tronfu/Voron-Mods/README.md

# Voron-Mods

A collection of my mods for Voron 2.4 and Trident
