tronfu/Voron-Mods/Retractable_Probe_Dock/README.md

# A Servo-powered Retractable Dock for Klicky Probe and Nozzle Brush
## for Voron 2.4 and Trident

<table>
  <tr>
    <td>
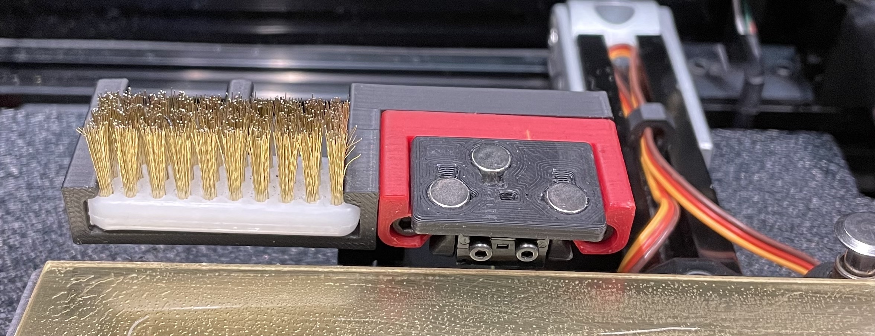
[picture p12: Retractable_Probe_Dock/Images/servo_dock_and_brush.jpg]
       
    </td>
    <td>
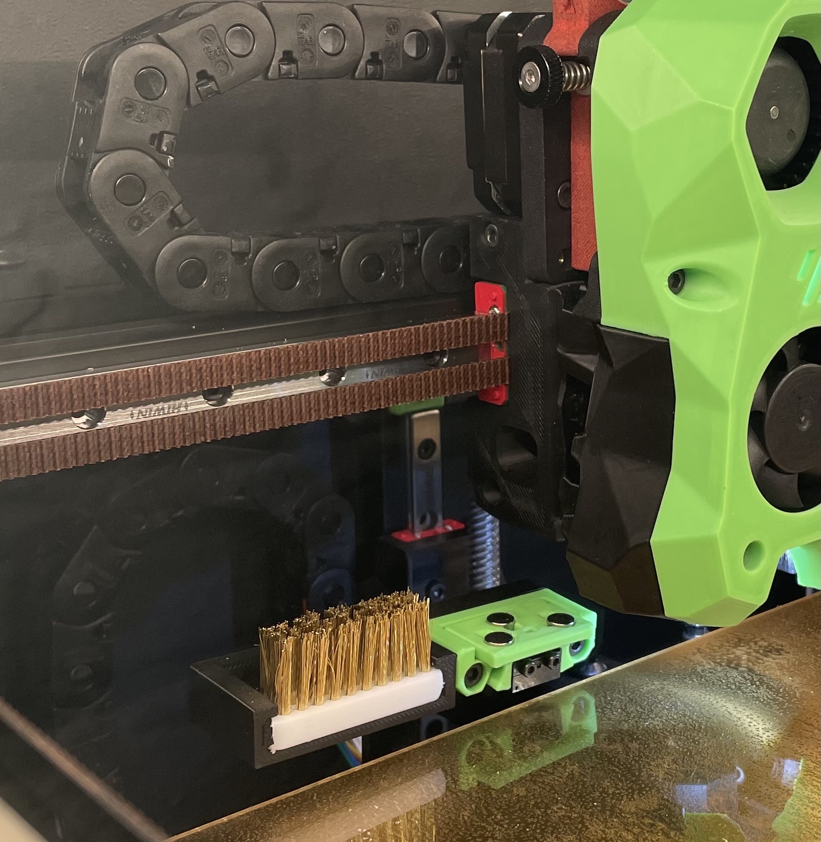
[picture p13: Retractable_Probe_Dock/Images/trident_extended_dock_front_view.jpg]
      
    </td>
  </tr>
</table>

## Background

I was not quite content with how the fixed nozzle worked. The back and forth motion of the nozzle either did not get the plastic bits off or got them off in one direction but picked them back up on the way back. Also, while I really like the Klicky probe, I had trouble consistently docking and undocking with the fixed Klicky probe dock on my Voron 2.4 350. Docking and undocking would work for a few print cycles then dock became slightly too far back for the toolhead to reach. So I created this servo-powered retractable dock and nozzle brush combo.

<table>
  <tr>
    <td>
       
    </td>
    <td>
      
    </td>
  </tr>
</table>

Below is a comparison of the servo brush vs. the stock fix brush.
<table>
  <tr>
    <td>
  <figure>
  
  &nbsp;<br/>
  <figcaption align="center">Nozzle after cleaning with fixed brush</figcaption>
  </figure>
  </td>
  <td>
  <figure>
  
  &nbsp;<br/>
  <figcaption align="center">Nozzle after cleaning with the servo brush</figcaption>
  </figure>
  </td>
  </tr>
</table>
&nbsp;<br/>
&nbsp;<br/>
You can certainly choose to use this design for only the Klick probe dock or only the nozzle brush by skipping the parts and assembly for the respective functionality. 

## BOM

Common:
* 1 x SG90 12g analog servo with metal gears, such as this one https://www.amazon.com/gp/product/B07KYK9N1G/
* 3 x 22-26 AWG wires at a length that can reach from the servo mounted by the print bed to your MCU
* 1 x JST XH Connector Plug 3 Position (for connecting to MCU)
* 1 x MicroFit3 Connector Receptacle 3 Position (for the other end of cable from MCU)
* 1 x MicroFit3 Connector Plug 3 Position (replace existing connector on the servo)
* 2 x M5x10mm BHCS screws  (for mounting the housing to the extrusion)
* 2 x M5 Spring T-nuts (for mounting the housing to the extrusion)
* 1 x M2x6mm screw (for securing the dock adaptor arm to the servo)

---
**NOTE**

A digital servo would work also. But some digital servos may flutter during extension (i.e., rapid vibrating as it tries to find the precise angle). An analog servo does not have this problem.

---
Klicky probe dock:
* 2 x M3x5mmx4mm heat inserts (for the dock adaptor arm)
* 2 x M3x20mm screws (for securing the dock to the dock adaptor arm, the same two screws used in the stock fixed dock setup)

Nozzle brush:
* 1 x Brass nozzle brush, such as this one https://www.amazon.com/gp/product/B092HWQG69. Of course, you can use a nozzle brush made of other materials, such as a silicone brush. But the current  brush holder has been tested for fit with brass nozzle from Amazon listed above.

## Assembly

### Setup the servo config
* Copy the retractable_probe_dock.cfg  to the directory where your printer.cfg file is (e.g., /home/pi/).

* In your printer.cfg file, also add the following [include retractable_probe_dock.cfg]. You can add it right after [include klicky-probe.cfg]. For example, this is what it looks like in my printer.cfg.
```
#####################################################################
# 	Macros
#####################################################################
[include klicky-probe.cfg]
[include retractable_probe_dock.cfg]
[include z_calibration.cfg]
```

* Add the following servo section to your printer.cfg.

```
[servo probe_dock_servo]
pin: P2.0            # P2.0 is for Skr 1.4, use the appropriate pin for your MCU
#   PWM output pin controlling the servo. This parameter must be
#   provided.
maximum_servo_angle: 180
#   The maximum angle (in degrees) that this servo can be set to. The
#   default is 180 degrees.
minimum_pulse_width: 0.0005
#   The minimum pulse width time (in seconds). This should correspond
#   with an angle of 0 degrees. The default is 0.001 seconds.
maximum_pulse_width: 0.0025
#   The maximum pulse width time (in seconds). This should correspond
#   with an angle of maximum_servo_angle. The default is 0.002
#   seconds.
initial_angle: 175
#   Initial angle (in degrees) to set the servo to. The default is to
#   not send any signal at startup.
#initial_pulse_width:
#   Initial pulse width time (in seconds) to set the servo to. (This
#   is only valid if initial_angle is not set.) The default is to not
#   send any signal at startup.
```
* Add extend_probe_dock and retract_probe_dock commands to attach_probe and dock_probe macros in your klicky-probe.cfg. See example below for where to insert. You can find a copy of my klicky-probe.cfg in the Macros folder for additional reference.

```
[gcode_macro Attach_Probe]

        ...

        _entry_point function=Attach_Probe_intern

        # RETRACTABLE BEGIN
        extend_probe_dock
        # RETRACTABLE END
        
        # Probe entry location
        G0 X{docklocation_x|int - attachmove_x|int} Y{docklocation_y|int - attachmove_y|int} F{travel_feedrate}
        {% if docklocation_z != -128 %}
            G0 Z{docklocation_z|int - attachmove_z|int} F{dock_feedrate}
        {% endif %}

        # Drop Probe to Probe location
        {% if docklocation_z != -128 %}
            G0 Z{docklocation_z} F{dock_feedrate}
        {% endif %}
        G0 X{docklocation_x} Y{docklocation_y} F{dock_feedrate}

        # Probe Attach
        {% if docklocation_z != -128 %}
        G0 Z{docklocation_z|int - attachmove_z|int} F{z_drop_feedrate}
        {% endif %}
        G0 X{docklocation_x|int - attachmove_x|int} Y{docklocation_y|int - attachmove_y|int} F{release_feedrate}

        # RETRACTABLE BEGIN
        retract_probe_dock
        # RETRACTABLE END
        
        # Go to Z safe distance
        {% if printer.toolhead.position.z < safe_z %}

        ...
        
[gcode_macro Dock_Probe]
    ...

        _Umbilical_Path

        # RETRACTABLE BEGIN
        extend_probe_dock
        # RETRACTABLE END
        
        # Probe entry location
        G0 X{docklocation_x|int - attachmove_x|int} Y{docklocation_y|int - attachmove_y|int} F{travel_feedrate}
        {% if docklocation_z != -128 %}
            G0 Z{docklocation_z|int - attachmove_z|int} F{dock_feedrate}
        {% endif %}

        # Drop Probe to Probe location
        G0 X{docklocation_x} Y{docklocation_y} F{dock_feedrate}
        {% if docklocation_z != -128 %}
            G0 Z{docklocation_z} F{dock_feedrate}
        {% endif %}

        # Probe decoupling
        {% if docklocation_z != -128 %}
            G0 Z{docklocation_z|int + dockmove_z|int} F{release_feedrate}
        {% endif %}
        G0 X{docklocation_x|int + dockmove_x|int} Y{docklocation_y|int + dockmove_y|int} F{release_feedrate}
        
        # RETRACTABLE BEGIN
        # RETRACTABLE adds the move below to move it back within max_bed_y
        G0 Y{docklocation_y|int - attachmove_y|int} F{release_feedrate}
        retract_probe_dock
        # RETRACTABLE END
        
        # Go to Z safe distance
        {% if printer.toolhead.position.z < safe_z %}
        
        ...        
```
### Wiring the servo to the MCU
* Power off the printer.
* Attach the servo to the servo port on your MCU. For example, on a SKR 1.4 Turbo, the servo port is the one inside the orange box shown in the picture below. 
<table>
  <tr>
    <td width="50%">

  </td>
  <td>
The three pins from the servo port labeled GND, NPWR, and 2.0 should be connected to the Negative Pole (Brown), Positive Pole (Red), and Signal (Yellow) pins of the Micro Servo as shown in the picture below.

  </td>
  </tr>
</table>

* Crimp the MicroFit3 Connector Receptacle onto the wires from mcu.
* Cut off the existing connector on the servo.
* Crimp the MicroFit3 Connector Plug onto the servo wires.

### Install the nozzle brush (skip if you are not using the Klicky probe dock feature)
* Heat set the two heat inserts.
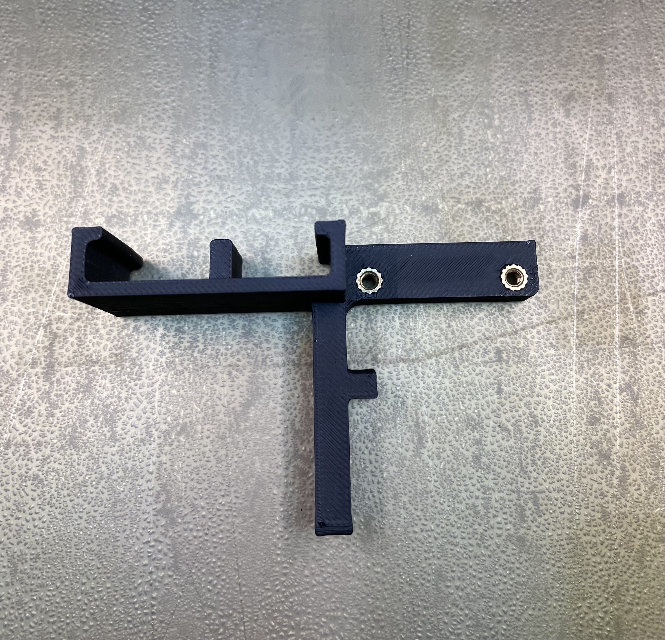
[picture p14: Retractable_Probe_Dock/Images/install_heat_inserts.jpg]


* Install the probe dock using the two M3 screws (the same ones for the stock dock mount).

### Install the nozzle brush (skip if you are not using the nozzle brush feature)
* Trim the nozzle brush so that it fits in the holder.


* Insert the trimmed brush into the holder.
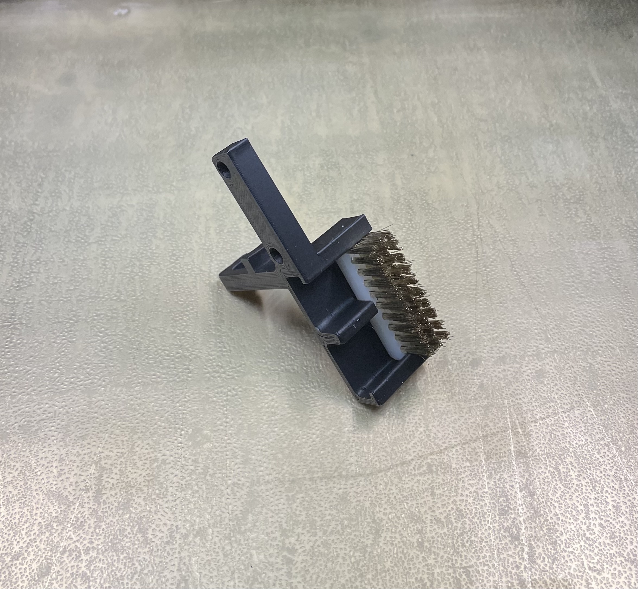
[picture p15: Retractable_Probe_Dock/Images/install_brush.jpg]

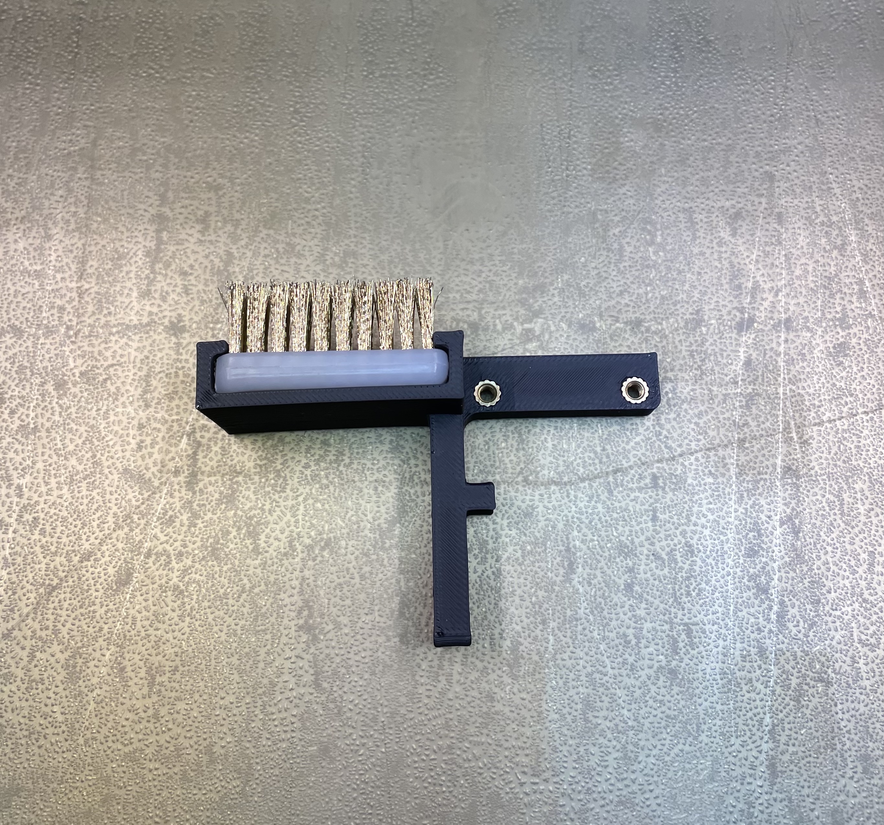
[picture p16: Retractable_Probe_Dock/Images/servo_arm_with_brush.jpg]


### Final assembly
* Install the servo into the housing using the two self-threading screws that come with the servo.



* Install the impact shield by pushing it all the way into the housing.
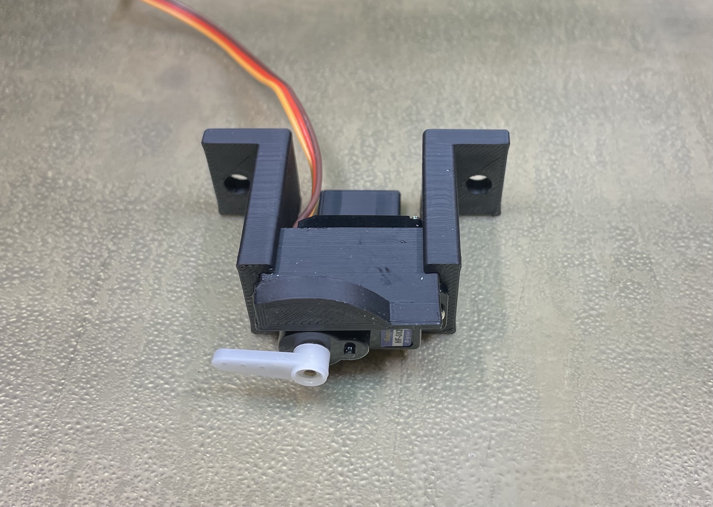
[picture p17: Retractable_Probe_Dock/Images/install_impact_shield.jpg]


* Put the two spring T-nuts in the extrusion and mount the housing to the extrusion (about 40 mm from the print bed on a V2.4 350). Don't tighten them too much. We will want to adjust the distance from the housing to the edge of the print bed.
* Connect the servo to the wires from the MCU.
* Power on the printer. If you have correctly inserted [servo probe_dock_servo] section into your printer.cfg, you should see the servo moving to the initial angle (e.g., 175 deg. in the sample setup) position up on boot up.
* Type the following command in a terminal to Klipper (e.g., under Octoprint's terminal tab): retractable_probe_dock.
(You should hear some clicking sound but the servo gear may not spin because it is at its initial angle position.)
* Attach the white plastic wing that came with the servo to the top of the servo. You can just press it down but don't need to screw it in yet.


* Put the dock adaptor arm over the white plastic wing, and secure the arm using a M2x6mm machine screw.
---
**NOTE**

You should use a small dab of Loctite (I used the red variety) on the the M2 screw to avoid having to re-tighten it periodically.

---
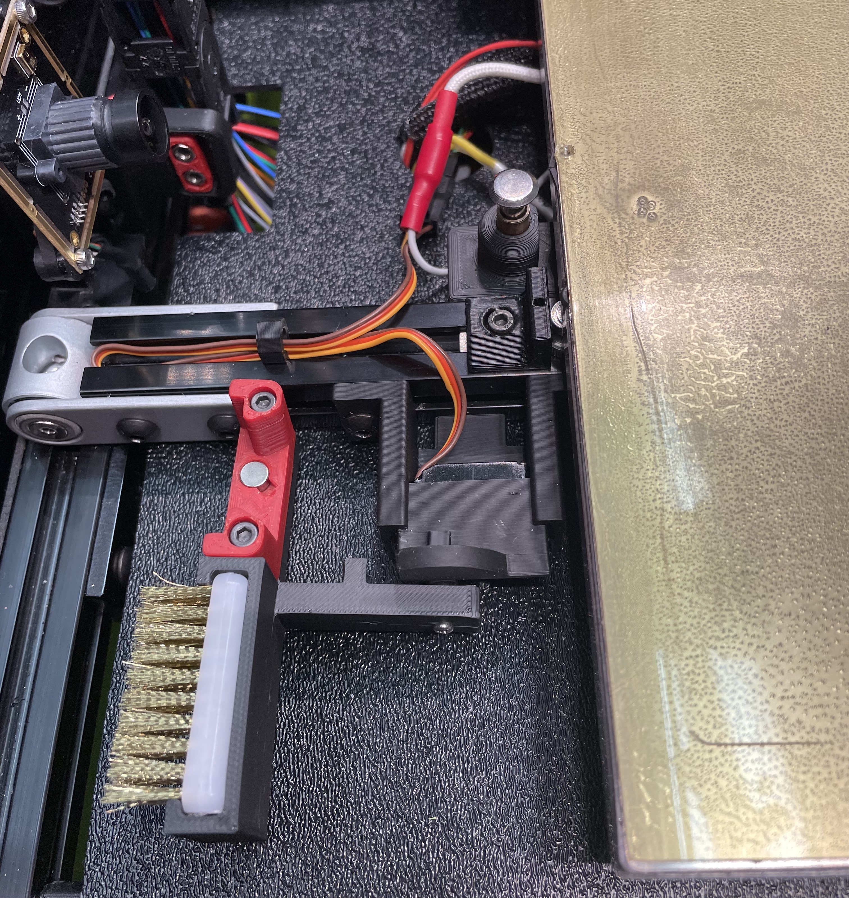
[picture p18: Retractable_Probe_Dock/Images/fully_installed.jpg]



### Initial configuration
* First, do a G28 to home everything.
* Do a few extend_probe_dock and retract_probe_dock to make sure the servo is working correctly.
### Skip the following steps if you are not using the Klicky probe dock feature
* Do a extend_probe_dock, then g0 z40.
* Then move your toolhead to be right above the extended dock using the G0 X__ Y__. 
* Slowly lower the z until the probe holder in the toolhead makes contact with the probe
* Do a GET_POSITION to get the X Y Z positions.
* Update klicky-probe.cfg with the positions (see example setup below)
```
variable_docklocation_x:        63    # X Dock position
variable_docklocation_y:        325   # Y Dock position
variable_docklocation_z:        9     # Z dock position (-128 for a gantry mount)

```
* Save the updated klicky-probe.cfg and do a FIRMWARE_RESTART
* Do a G28 to home XYZ
* Do an attach_probe and a dock_probe to see the retractable dock working as intended.

#### Skip the following steps if you are not using the nozzle brush feature
* Do an extend_probe_dock
* Move the nozzle until the x is at the brush start and y is at brush_front
```
                  ←   brush_width   →                            
                   _________________                                                          ↑                 |                 |  ↑                     
  brush_start (x) |                 | brush_depth            
                  |_________________|  ↓                                      
                          (y)                                                                
↓                      brush_front
 __________________________________________________________
                     PRINTER FRONT
```

* Do a GET_POSITION and update retractable_probe_dock.cfg (see example setup below)
```
variable_brush_front:       340          
variable_brush_depth:       10       
``` 
* Do a FIRMWARE_RESTART followed by a G28 to home everything
* Do a cleaning_nozzle to see the brushing in action

### Auto docklocation_z configuration
* Copy the calibrate_docklocation_z.py script into the klipper/klippy/extras directory (e.g., on my set up the full path is /home/pi/klipper/klippy/extras).
* Make sure you have the latest retractable_probe_dock.cfg that has the following configuration:
```
[calibrate_docklocation_z]
#speed:                       50     # default 50
##  the toolhead will start at docklocation_z_max and move down to
##  docklocation_z_min to find the correct docklocation_z
docklocation_z_max:          30
docklocation_z_min:          8       
##  The magnet will pull the dock up when doing a CALIBRATE_DOCKLOCATION_Z. 
##  The docklocation_z_offset will compensate for that by setting the docklocation_z 
##  slightly lower
docklocation_z_offset:       -2 

[gcode_macro find_docklocation_z]
gcode:
    {% set docklocation_x = printer["gcode_macro _User_Variables"].docklocation_x %}
    {% set docklocation_y = printer["gcode_macro _User_Variables"].docklocation_y %}
    {% set dockmove_x = printer["gcode_macro _User_Variables"].dockmove_x|default(0) %}
    {% set dockmove_y = printer["gcode_macro _User_Variables"].dockmove_y|default(0) %}
    {% set release_feedrate = printer["gcode_macro _User_Variables"].release_feedrate|default(1000) %}
    extend_probe_dock
    CALIBRATE_DOCKLOCATION_Z X={docklocation_x} Y={docklocation_y}
    G0 X{docklocation_x|int + dockmove_x|int} Y{docklocation_y|int + dockmove_y|int} F{release_feedrate}
    { action_respond_info("find_sdocklocation_z: " + printer.calibrate_docklocation_z.docklocation_z|string) }
    
[gcode_macro set_docklocation_z]
gcode:
    SET_GCODE_VARIABLE MACRO=_User_Variables VARIABLE=docklocation_z VALUE={printer.calibrate_docklocation_z.docklocation_z}
    { action_respond_info("set_docklocation_z: " + printer.calibrate_docklocation_z.docklocation_z|string) }
    
## Wrapper macro to get around Jinja expansion order issue
[gcode_macro auto_set_docklocation_z]
gcode:
    find_docklocation_z
    set_docklocation_z
```
* Call the auto_set_docklocation_z macro at least once after you restart your printer (including running RUNNING and FIRMWARE_RESTART commands) before any docking/undocking. For example, you can add auto_set_docklocation_z right after G28 in your G32 definition.
