tronfu/Voron-Mods/Bowden_Tube_Clip/README.md

# Bowden Tube Clip

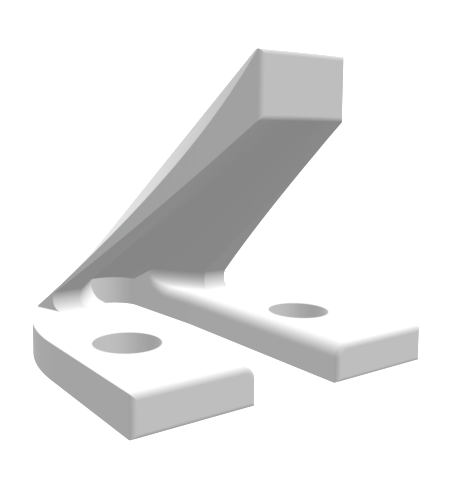
[picture p19: Bowden_Tube_Clip/Images/bowden_tube_clip_3d_render.png]


I created a simple clip to keep the Bowden tube upright and not get caught in the moving chain or the gantry.

## BOM

* 2 x M5x6mm (or M5x8mm) BHCS
* M5 Spring T-nuts

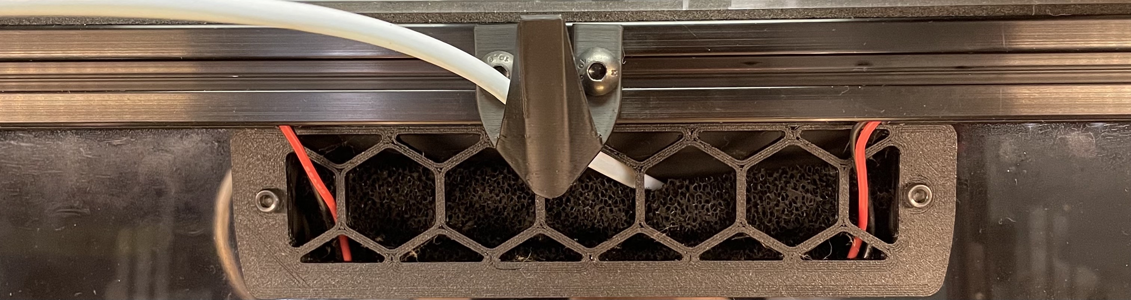
[picture p20: Bowden_Tube_Clip/Images/bowden_tube_clip.jpg]
