tronfu/Voron-Mods/Better_Bed_Hinge/Images/perpendicular_pivot.jpg

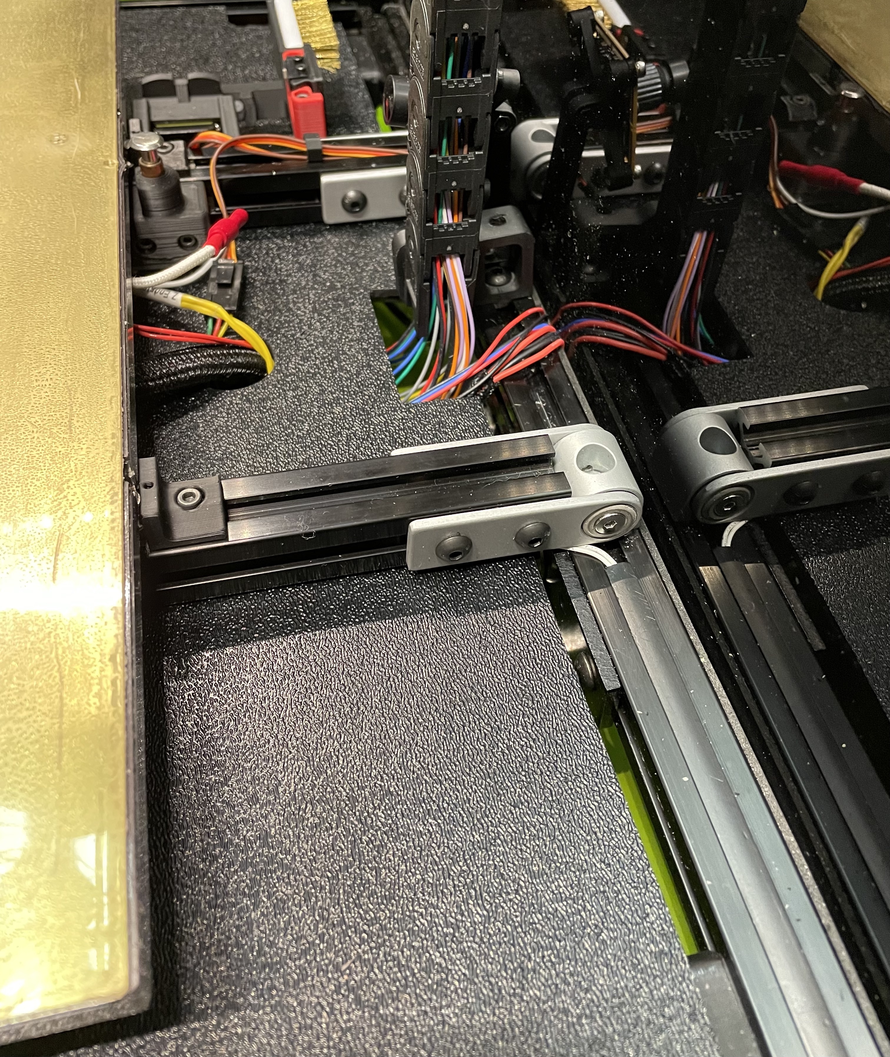
Better_Bed_Hinge/Images/perpendicular_pivot.jpg
