tronfu/Voron-Mods/Retractable_Probe_Dock/Images/12g_EMax_Analog_Servo.jpg

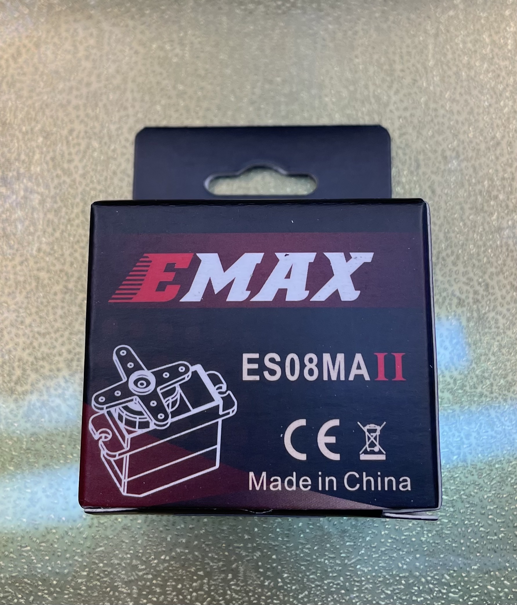
Retractable_Probe_Dock/Images/12g_EMax_Analog_Servo.jpg
