tronfu/Voron-Mods/Retractable_Probe_Dock/Images/completed_servo_arm.jpg

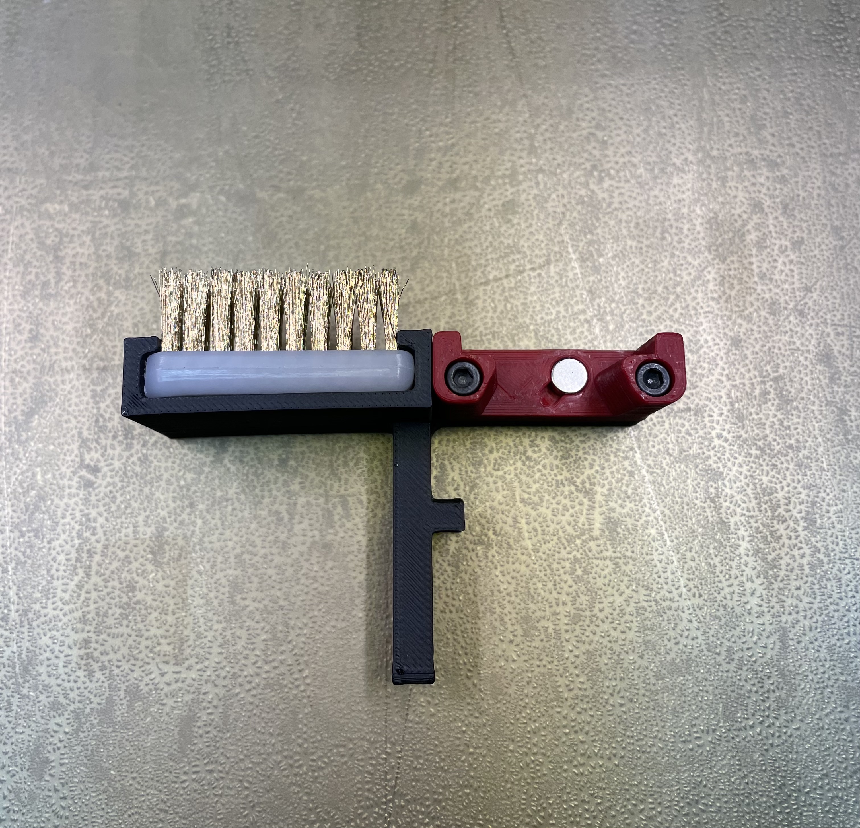
Retractable_Probe_Dock/Images/completed_servo_arm.jpg
