tronfu/Voron-Mods/Retractable_Probe_Dock/Images/trident_retracted_dock.jpg

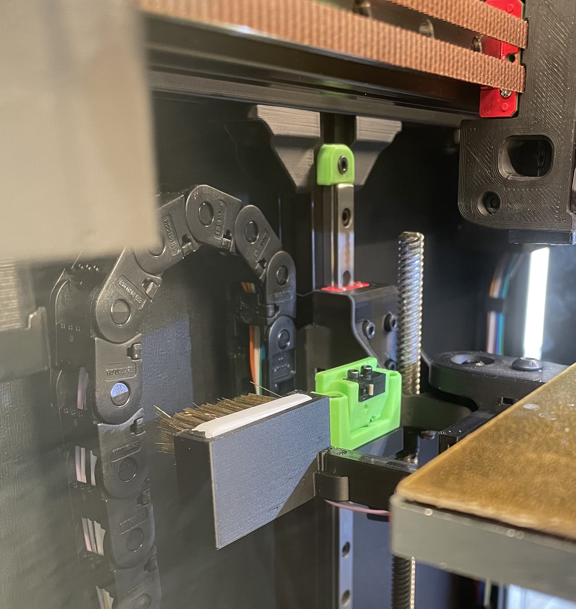
Retractable_Probe_Dock/Images/trident_retracted_dock.jpg
