tronfu/Voron-Mods/Better_Bed_Hinge/DXFs/Deck_Panel_350_Modified.dxf

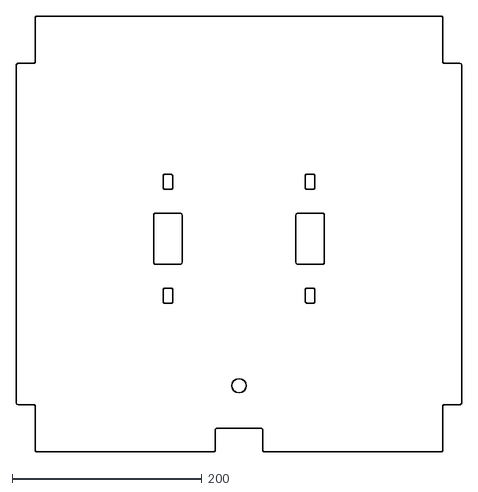
[picture p40: CAD file, 2022-01-28]
Better_Bed_Hinge/DXFs/Deck_Panel_350_Modified.dxf
470.0 x 460.0
