tronfu/Voron-Mods/Better_Bed_Hinge/STLs/DIN_frame_mount_x4.stl

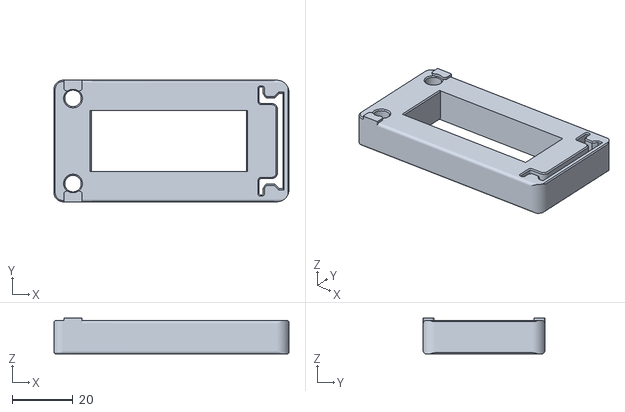
[picture p41: CAD file, 2022-02-01]
Better_Bed_Hinge/STLs/DIN_frame_mount_x4.stl
77.2 x 40.0 x 11.8
