tronfu/Voron-Mods/Bowden_Tube_Clip/STLs/Bowden_tube_clip.stl

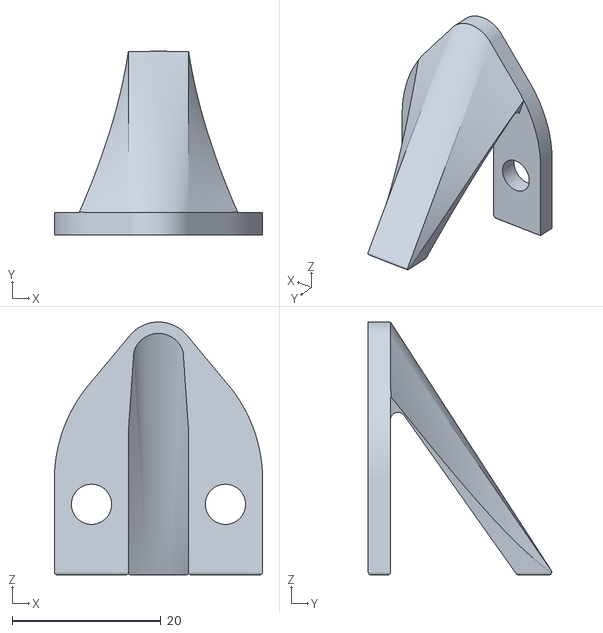
[picture p42: CAD file, 2022-03-06]
Bowden_Tube_Clip/STLs/Bowden_tube_clip.stl
28.0 x 24.7 x 34.0
