tronfu/Voron-Mods/Retractable_Probe_Dock/STLs/Trident_housing.stl

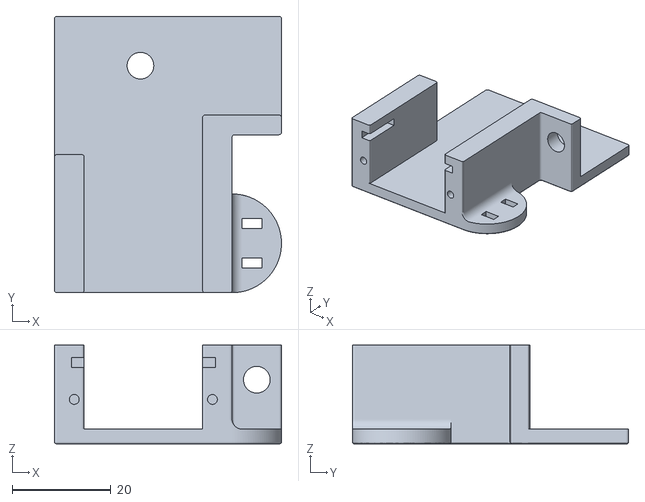
[picture p43: CAD file, 2022-03-03]
Retractable_Probe_Dock/STLs/Trident_housing.stl
46.0 x 56.0 x 20.0
