tronfu/Voron-Mods/Servo_Nozzle_Brush/STLs/Adjustable_brush_holder.stl

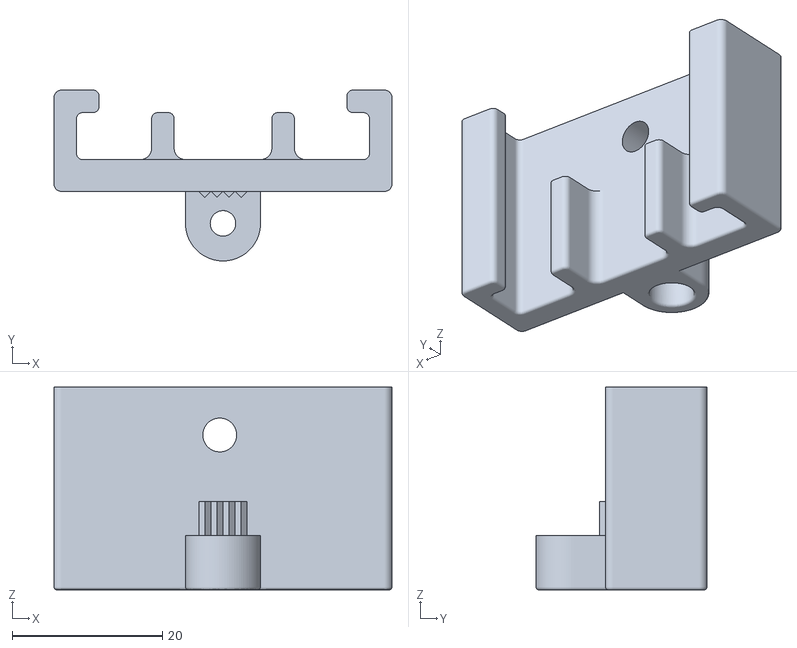
[picture p44: CAD file, 2023-02-01]
Servo_Nozzle_Brush/STLs/Adjustable_brush_holder.stl
45.0 x 22.7 x 27.0
