tronfu/Voron-Mods/Better_Bed_Hinge/STLs/Voron_2.4_Deck_Panel_Hole_Plug_x4.stl

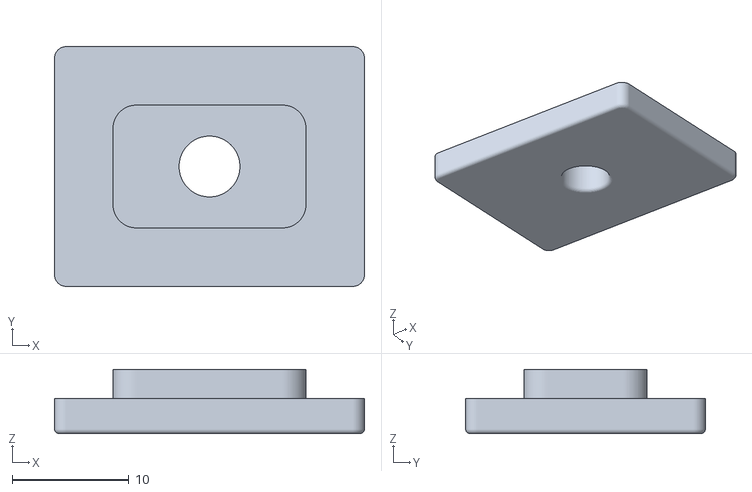
[picture p45: CAD file, 2022-01-28]
Better_Bed_Hinge/STLs/Voron_2.4_Deck_Panel_Hole_Plug_x4.stl
26.5 x 20.5 x 5.50
