tronfu/Voron-Mods/Retractable_Probe_Dock/STLs/Adjustable_arm.stl

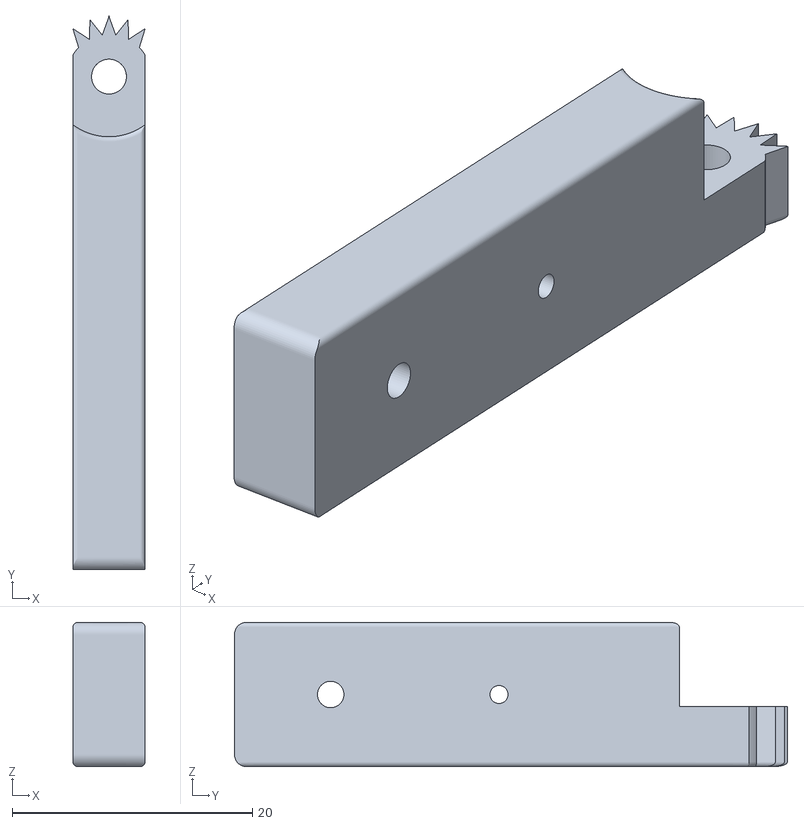
[picture p46: CAD file, 2022-03-03]
Retractable_Probe_Dock/STLs/Adjustable_arm.stl
6.00 x 46.0 x 12.0
