tronfu/Voron-Mods/Better_Bed_Hinge/STLs/Bed_handle.stl

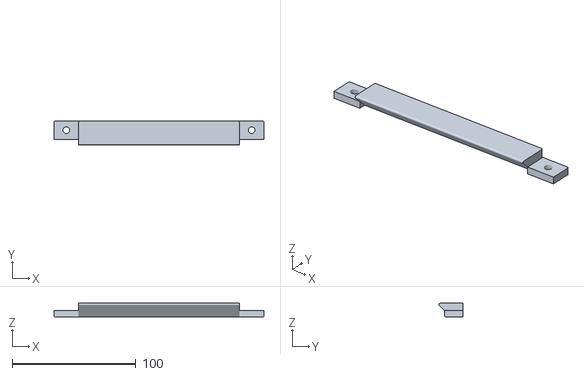
[picture p47: CAD file, 2022-01-28]
Better_Bed_Hinge/STLs/Bed_handle.stl
170.0 x 19.6 x 11.0
