tronfu/Voron-Mods/Retractable_Probe_Dock/STLs/Adjustable_brush_dock_holder.stl

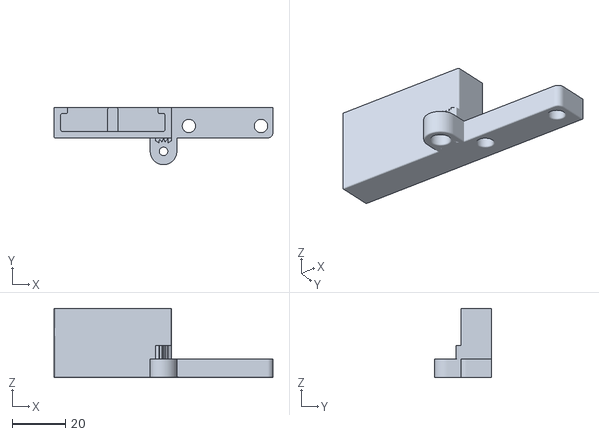
[picture p48: CAD file, 2022-03-03]
Retractable_Probe_Dock/STLs/Adjustable_brush_dock_holder.stl
82.0 x 21.5 x 26.0
