tronfu/Voron-Mods/Retractable_Probe_Dock/STLs/Servo_arm.stl

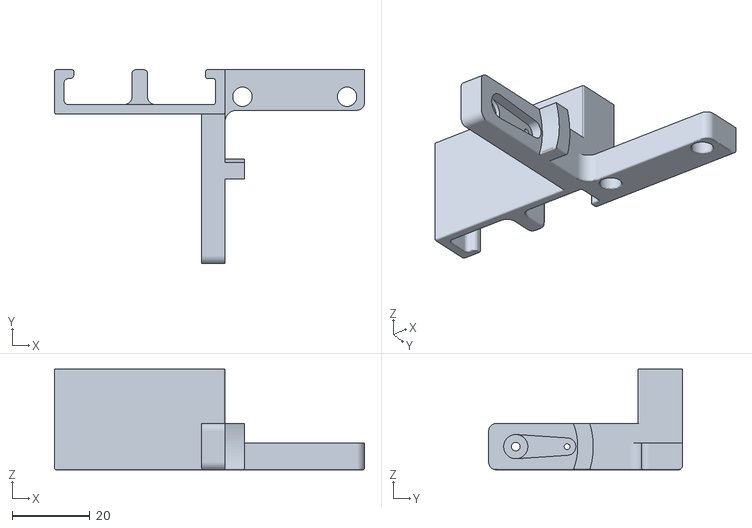
[picture p49: CAD file, 2022-01-23]
Retractable_Probe_Dock/STLs/Servo_arm.stl
80.0 x 50.0 x 26.0
