tronfu/Voron-Mods/Retractable_Probe_Dock/STLs/Impact_relief.stl

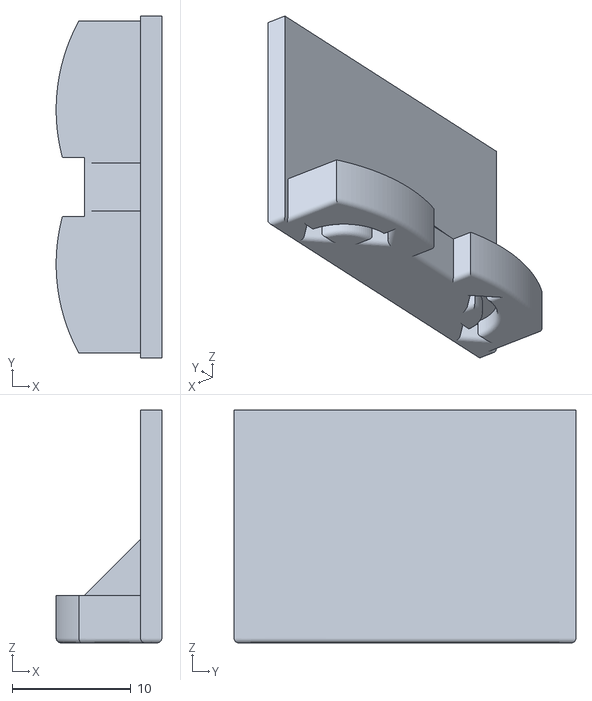
[picture p50: CAD file, 2022-01-23]
Retractable_Probe_Dock/STLs/Impact_relief.stl
8.90 x 28.8 x 19.6
