tronfu/Voron-Mods/Retractable_Probe_Dock/STLs/Housing.stl

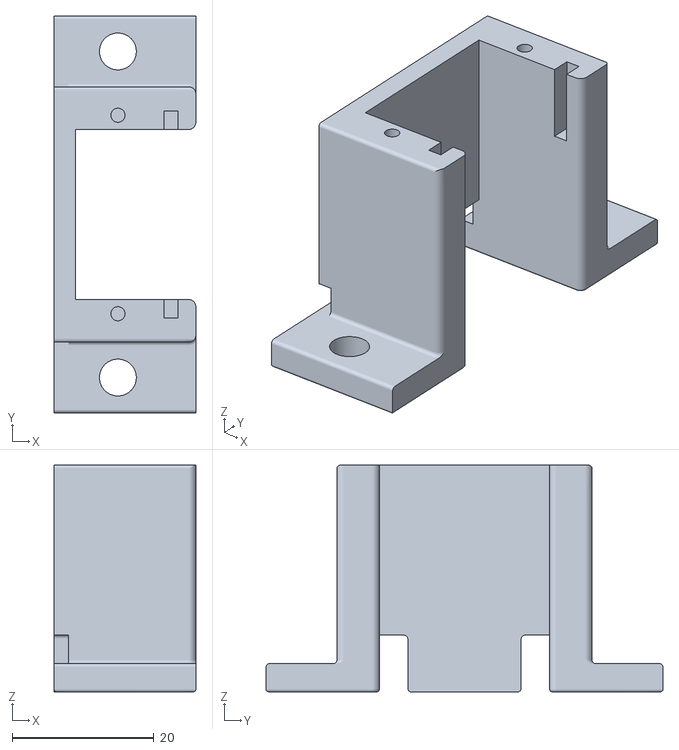
[picture p51: CAD file, 2022-01-23]
Retractable_Probe_Dock/STLs/Housing.stl
20.0 x 56.0 x 32.0
