tronfu/Voron-Mods/Tridex/Auto_3-Axes_Calibration/Images/calibration_tool_side_view.jpg

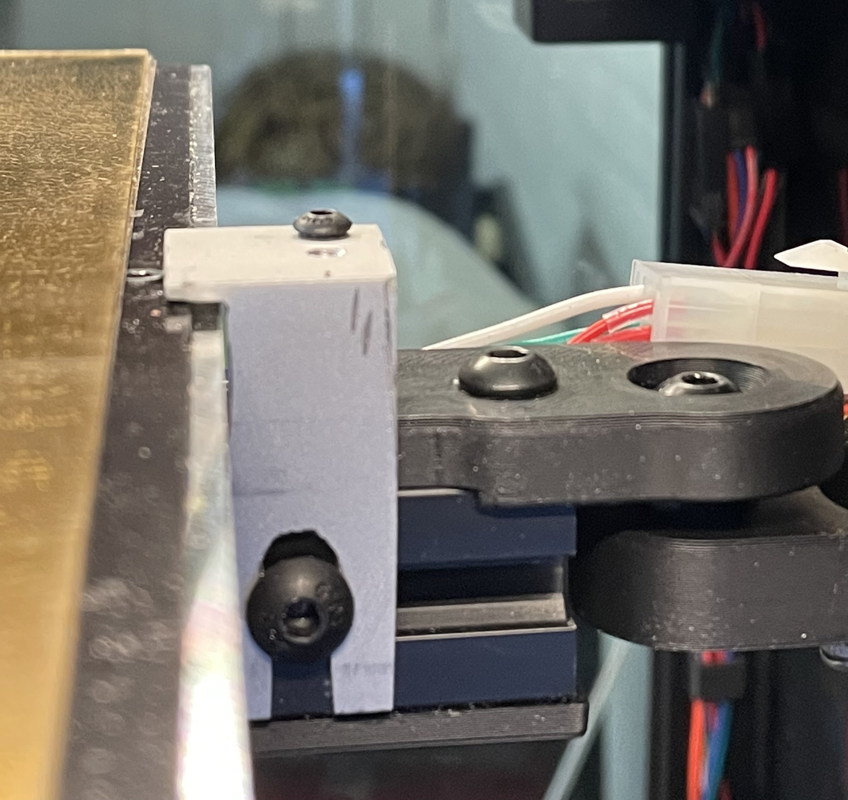
Tridex/Auto_3-Axes_Calibration/Images/calibration_tool_side_view.jpg
