tronfu/Voron-Mods/(threads)

Thread 1 (2022-03-01):

docklocation_z = ?

bjoern79de, 2022-03-01:
It would be nice, if docklocation_z could be determined automaticly (by using the actual probe-attachment as a second z-endstop). One of the main advantages of klicky-probe is to use it together with klipper_z_calibration, to be able to replace nozzles/printheads without any reconfigurations. I have height-differences of up to 10mm between my printheads - so I would have to reconfigure the docklocation_z instead of z-offset every time.

tronfu, 2022-03-01:
Thanks for the suggestion. Is this a problem only with the servo-dock or also with the stock gantry-mounted dock?

bjoern79de, 2022-03-02:
Only with a non-gantry-mounted dock. With gantry-mounted docks, the z-location is not relevant.

tronfu, 2022-03-02:
Understood. When you say using the actual probe-attachment as a second z-endstop, what exactly are you envisioning? Can you visually illustrate that for me?

tronfu, 2022-03-03:
This functionality has been added. See the latest README.

Thread 2 (2022-05-14):

Bottom fastener for Trident_housing.stl for retractable probe is too long

kyleisah, 2022-05-14:
Hello, the BOM M5x10 fastener is too long for Trident_housing.stl, the bolt will bottom out into the extrusion and provide no grip. The mount needs to be thickened or shims will need to be added to the BOM. My vote is on thickening the housing. :)

kyleisah, 2022-05-14:
Seems the side of the mount is 4mm, and the bottom of the mount is 3mm. This is what I gathered from converting the mesh to a solid in CAD at least. If there was a CAD available I'd be able to just make a PR for the STL.

Thread 3 (2022-07-23):

Servo oscillation

axg20202, 2022-07-23:
Any idea why my servo would start oscillating/jittering when extended? It has been working for a few months, so no parameters have been changed.

tronfu, 2022-07-23:
Is your servo analog or digital?

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

axg20202, 2022-07-24:
Hi. It's analog. It's an EMAX ES08MA I.

axg20202, 2022-07-25:
I did have to lengthen the servo arm printed part by 8mm to get the dock to sit higher above my bed. Maybe that added length is causing the issue through too much wobble?

tronfu, 2022-07-25:
That’s possible. I would try the shorter arm to see if the wobble goes away.

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

Thread 4 (2022-11-24):

Servo Arm voron 300

BOAndy1985, 2022-11-24:
Hello, could you edit the Servo Arm.stl so that the brush is on the right side and the clicky holder is removed?  Problem is it doesn't fit with a voron 300. LG BO_Andy

Thread 5 (2023-04-09):

BOM item link is incorrect

jet8300, 2023-04-09:
I ordered the servos in your BOM (Amazon link) and they do not fit the 3d printed parts at all.

I will probably do a mod of this so that I can use the servos I purchased (I've already cut wires). Would you be willing to share the cad files?

jet8300, 2023-04-09:
Nevermind. I was mistaken. I was not assembling correctly. My apologies.

Closed 2023-04-09.

Thread 6 (2024-01-29):

Servo arm screw can't be tightened

YoungHillionaire, 2024-01-29:
Having issues tightening the servo arm screw
tried m2x6 and m2x8

Thread 7 (2024-03-04):

Are there STLs missing ?

kernelsandoz, 2024-03-04:
Hi,

I watched the YouTube video and got excited about making this project. Ordered the servo motor.

Should there be some other STL files or have I missed something ?

Thanks for sharing your work.

kernelsandoz, 2024-03-04:
I did miss something. My apologies. I need to see the klippy probe project for the STLs.

Thread 8 (2024-09-18):

named_probe.py problem?

onkel-serg, 2024-09-18:
Hi,
thank you for your work.

After update my printer shows error:
Internal error during connect: 'PrinterNamedProbe' object has no attribute '_handle_homing_move_begin'.

Unfortenatly I have no klue how to deal with it. I haven't made any changes in named_probe.py.
