tronfu/Voron-Mods/Tridex/Auto_3-Axes_Calibration/Klipper_firmware/printer.cfg

# This file contains common pin mappings for the BigTreeTech OctoPus V1.
# To use this config, the firmware should be compiled for the STM32F446 with a "32KiB bootloader"
# Enable "extra low-level configuration options" and select the "12MHz crystal" as clock reference

# after running "make", copy the generated "klipper/out/klipper.bin" file to a
# file named "firmware.bin" on an SD card and then restart the OctoPus with that SD card.

# See docs/Config_Reference.md for a description of parameters.

## Voron Design Trident 250/300/350mm BigTreeTech OctoPus V1 TMC2209 UART config

## *** THINGS TO CHANGE/CHECK: ***
## MCU paths							[mcu] section
## Thermistor types						[extruder] and [heater_bed] sections - See 'sensor types' list at end of file
## Z Endstop Switch location			[safe_z_home] section
## Homing end position				[gcode_macro G32] section
## Z Endstop Switch  offset for Z0		[stepper_z] section
## Probe points							[quad_gantry_level] section
## Min & Max gantry corner postions		[quad_gantry_level] section
## PID tune								[extruder] and [heater_bed] sections
## Probe pin								[probe] section
## Fine tune E steps					[extruder] section

[include IDEX_mode.cfg]
[include idex_offsets_helpers.cfg]
[include pins.cfg]

[mcu]
canbus_uuid=3f506a70e4f1

##	Obtain definition by "ls -l /dev/serial/by-id/" then unplug to verify
##--------------------------------------------------------------------
#serial: /dev/serial/by-id/usb-Klipper_stm32f429xx_380030000450314B33323220-if00
## Below are for UART connection
#serial: /dev/ttyAMA0
#restart_method: command
##--------------------------------------------------------------------

[mcu head0]
canbus_uuid: 29e28f2aa1b8   ; unterminated

[mcu head1]
canbus_uuid: 10b74da1160a   ; terminated

#--------------------------------------------------------------------
# resonance test
#
# https://www.klipper3d.org/Measuring_Resonances.html

[mcu rpi]
serial: /tmp/klipper_host_mcu

#[adxl345]
#cs_pin: rpi:None

[adxl345 head0]
cs_pin: head0:ADXL_CS
spi_software_sclk_pin: head0:ADXL_SCLK
spi_software_mosi_pin: head0:ADXL_MOSI
spi_software_miso_pin: head0:ADXL_MISO

[adxl345 head1]
cs_pin: head1:ADXL_CS
spi_software_sclk_pin: head1:ADXL_SCLK
spi_software_mosi_pin: head1:ADXL_MOSI
spi_software_miso_pin: head1:ADXL_MISO

[resonance_tester]
accel_chip: adxl345 head1
max_freq: 45
#   Maximum frequency to test for resonances. The default is 133.33 Hz.
probe_points:
    125,125,20  # an example
   
[printer]
kinematics: hybrid_corexy
max_velocity: 300  
max_accel: 4000    			#Max 4000
max_z_velocity: 25 			#Max 15 for 12V TMC Drivers, can increase for 24V
max_z_accel: 350
square_corner_velocity: 5.0

#need to be on Klipper Pull Request #5311 to use Input Shaper
[input_shaper]
shaper_freq_x: 41.8 ; 53
shaper_type_x: mzv
shaper_freq_dc: 43.2 
shaper_type_dc: mzv
shaper_freq_y: 33.0
shaper_type_y: mzv


[force_move]
enable_force_move:true

#####################################################################
# 	X/Y Stepper Settings
#####################################################################

########################################
# X Steppers
########################################

## X Stepper on MOTOR5
[stepper_x]
step_pin: MOT5_STEP
dir_pin: MOT5_DIR
enable_pin: !MOT5_EN
rotation_distance: 40
microsteps: 32
full_steps_per_rotation:200  #set to 400 for 0.9 degree stepper
endstop_pin: head0:gpio29

position_endstop: -50
position_min: -52
position_max: 228

##--------------------------------------------------------------------
homing_speed: 60   #Max 100
homing_retract_dist: 5
second_homing_speed: 10
#homing_positive_dir: true

##	Make sure to update below for your relevant driver (2208 or 2209)
[tmc2209 stepper_x]
uart_pin: MOT5_CS
#interpolate: False # True
run_current: 0.8
#sense_resistor: 0.110
stealthchop_threshold: 0

## X1 Stepper on MOTOR4
[dual_carriage]
axis: x
step_pin: MOT4_STEP
dir_pin: MOT4_DIR
enable_pin: !MOT4_EN
microsteps: 32
rotation_distance: 40
endstop_pin: head1:gpio29

position_endstop: 22.4
position_min: 22
position_max: 300   ; 300
homing_speed: 60
homing_retract_dist: 5
second_homing_speed: 10

[tmc2209 dual_carriage]
uart_pin: MOT4_CS
run_current: 0.8
stealthchop_threshold: 0

########################################
# Y Steppers
########################################

## Y Stepper on MOTOR3
[stepper_y]
step_pin: MOT3_STEP
dir_pin: !MOT3_DIR
enable_pin: !MOT3_EN
rotation_distance: 40
microsteps: 32
#full_steps_per_rotation:200  #set to 400 for 0.9 degree stepper
endstop_pin: ESTOP0

position_min: -5
position_endstop: 255
position_max: 255

##--------------------------------------------------------------------
homing_speed: 40  #Max 100
homing_retract_dist: 5
homing_positive_dir: true

##	Make sure to update below for your relevant driver (2208 or 2209)
[tmc2209 stepper_y]
uart_pin: MOT3_CS
interpolate: False # True
run_current: 0.8
sense_resistor: 0.110
stealthchop_threshold: 0

## Y1 Stepper on MOTOR6
[stepper_y1]
step_pin: MOT6_STEP
dir_pin: MOT6_DIR
enable_pin: !MOT6_EN
microsteps: 32
rotation_distance: 40
#endstop_pin: ^PG9 #^PA2 #y-max tmc2209_stepper_y1:virtual_endstop
endstop_pin: ESTOP1

[tmc2209 stepper_y1]
uart_pin: MOT6_CS
run_current: 0.8
stealthchop_threshold: 0

#####################################################################
# 	Z Stepper Settings
#####################################################################

##  Z0 Stepper - Front Left (M1)
##  Connected to MOTOR_0
##  Endstop connected to DIAG_2
[stepper_z]
step_pin: MOT0_STEP
dir_pin: !MOT0_DIR
enable_pin: !MOT0_EN
microsteps: 16
##T8x4 Lead Screws.  One rotation moves the bed 4mm 
##T8x8 Lead Screws.  One rotation moves the bed 8mm 
##Change according to integrated steppers purchased
rotation_distance: 8
#full_steps_per_rotation: 200
#endstop_pin: PG10
endstop_pin: named_probe:z_virtual_endstop
#  Z-position of nozzle (in mm) to z-endstop trigger point relative to print surface (Z0)
#  (+) value = endstop above Z0, (-) value = endstop below
#  Increasing position_endstop brings nozzle closer to the bed
#  After you run Z_ENDSTOP_CALIBRATE, position_endstop will be stored at the very end of your config
#position_endstop: 1.175
# Klicky PCB
#position_endstop: 5.432
## All builds use same Max Z
position_max: 247      ; default 250
position_min: -2.5
homing_speed: 20

[tmc2209 stepper_z]
uart_pin: MOT0_CS
interpolate: False
run_current: 0.650
#hold_current: 0.450
#sense_resistor: 0.110
stealthchop_threshold: 0 # 30 # old was 30

##  Z1 Stepper - Rear Center (M2)
##  Connected to MOTOR_1
[stepper_z1]
step_pin: MOT1_STEP
dir_pin: !MOT1_DIR
enable_pin: !MOT1_EN
microsteps: 16              # 16 with interpolate True, 32 with interpolate False
rotation_distance: 8
#full_steps_per_rotation: 200

[tmc2209 stepper_z1] ;z1
uart_pin: MOT1_CS
interpolate: False
run_current: 0.650
#hold_current: 0.450
#sense_resistor: 0.110
stealthchop_threshold: 0 # 30 # old was 30

##  Z2 Stepper - Front Right (M3)
##  Connected to MOTOR_2
[stepper_z2] ;z2
step_pin: MOT2_STEP
dir_pin: !MOT2_DIR
enable_pin: !MOT2_EN
microsteps: 16
rotation_distance: 8
#full_steps_per_rotation: 200

[tmc2209 stepper_z2]
uart_pin: MOT2_CS
interpolate: False
run_current: 0.650
#hold_current: 0.450
#sense_resistor: 0.110
stealthchop_threshold: 0 # 30 # old was 30


[thermistor Trianglelab_T-D500]
# https://docs.dyzedesign.com/general-support/temperature-sensors.html#_500%C2%B0c-thermistor
# https://www.ametherm.com/thermistor/ntc-thermistor-beta
# 200C - 8070 ohm
# 440C - 157 ohm
temperature1: 200
resistance1: 8070
beta: 5538.95


########################################
# Extruder 0 (T0) - Left
########################################

[extruder]
step_pin: head0:EXT_STEP
dir_pin: head0:EXT_DIR
enable_pin: !head0:EXT_EN
max_extrude_only_distance: 101
##	Update value below when you perform extruder calibration
##	If you ask for 100mm of filament, but in reality it is 98mm:
##	rotation_distance = <previous_rotation_distance> * <actual_extrude_distance> / 100
##  22.6789511 is a good starting point
# Default for Bondtech 5mm Bore Drive Gears
#rotation_distance: 22.6789511
#rotation_distance: 22.2253721	#Bondtech 5mm Drive Gears
# Default for Bondtech 5mm Bore Drive Gears
#rotation_distance: 22.6789511
# Bondtech LGX Lite
rotation_distance: 5.614  ; 5.7
##	Update Gear Ratio depending on your Extruder Type
##	Use 50:17 for Afterburner/Clockwork (BMG Gear Ratio)
##	Use 80:20 for M4, M3.1
## Bondtech LGX
#rotation_distance:  54.45 #55 #for LGX        #for mini AB  21.855 #21.8553543599825 #21.8851878115 #22.6789511 #22.23        # See calibrating rotation_distance on extruders doc
#gear_ratio: 45:14, 37:17 #for LGX      # For Mini Afterburner 50:10 
#end LGX
#gear_ratio: 50:17				#BMG Gear Ratio
microsteps: 16
full_steps_per_rotation: 200	#200 for 1.8 degree, 400 for 0.9 degree
nozzle_diameter: 0.400
filament_diameter: 1.75
heater_pin: head0:HE0
##	Validate the following thermistor type to make sure it is correct
#sensor_type: ATC Semitec 104GT-2
sensor_type: Trianglelab_T-D500
sensor_pin: head0:TH_0
#min_temp: 10
min_temp: -273.15
max_temp: 270
max_power: 1.0
min_extrude_temp: 170
control: pid
#pid_Kp: 29.059 
#pid_Ki: 2.306 
#pid_Kd: 91.536
pid_Kp: 27.902 
pid_Ki: 2.163 
pid_Kd: 89.980
##	Try to keep pressure_advance below 1.0
pressure_advance: 0.066  ; 0.05
##	Default is 0.040, leave stock
pressure_advance_smooth_time: 0.040

##	Make sure to update below for your relevant driver (2208 or 2209)
[tmc2209 extruder]
uart_pin: head0:EXT_UART
interpolate: false
run_current: 0.5
#hold_current: 0.4
sense_resistor: 0.110
stealthchop_threshold: 0

## SB2040温度
[temperature_sensor T0]
sensor_type: temperature_mcu
sensor_mcu: head0

## SB2040板载NTC100K温度
[temperature_sensor T0-ambient]
sensor_type = ATC Semitec 104GT-2
sensor_pin = head0:TH_NTC
min_temp: -50
max_temp: 350

## HOT END FAN
[heater_fan hotend_fan0]
pin: head0:FAN_HE
max_power: 1.0
kick_start_time: 0.5
heater: extruder
heater_temp: 70.0 ; account for the high reading of SB2040 default 50.0
#fan_speed: 1.0

[fan_generic fanX1]
pin: head0:FAN_PC
cycle_time: 0.0100
kick_start_time: 1.00
hardware_pwm: false

########################################
# Extruder 1 (T1) - Right
########################################

[extruder1]
step_pin: head1:EXT_STEP
dir_pin: head1:EXT_DIR
enable_pin: !head1:EXT_EN
max_extrude_only_distance: 101
# Bondtech LGX Lite
rotation_distance: 5.572 ;   5.7
#gear_ratio: 50:17				#BMG Gear Ratio
microsteps: 16
full_steps_per_rotation: 200	#200 for 1.8 degree, 400 for 0.9 degree
nozzle_diameter: 0.400
filament_diameter: 1.75
heater_pin: head1:HE0
##	Validate the following thermistor type to make sure it is correct
#sensor_type: ATC Semitec 104GT-2
sensor_type: Trianglelab_T-D500
sensor_pin: head1:TH_0
#min_temp: 10
min_temp: -273.15
max_temp: 270
max_power: 1.0
min_extrude_temp: 170
control: pid
#pid_Kp: 29.059 
#pid_Ki: 2.306 
#pid_Kd: 91.536
pid_Kp: 27.702 
pid_Ki: 1.866 
pid_Kd: 102.841

##	Try to keep pressure_advance below 1.0
pressure_advance: 0.066 ; 0.05
##	Default is 0.040, leave stock
pressure_advance_smooth_time: 0.040

##	Make sure to update below for your relevant driver (2208 or 2209)
[tmc2209 extruder1]
uart_pin: head1:EXT_UART
interpolate: false
run_current: 0.5
#hold_current: 0.4
sense_resistor: 0.110
stealthchop_threshold: 0

## SB2040温度
[temperature_sensor T1]
sensor_type: temperature_mcu
sensor_mcu: head1

## SB2040板载NTC100K温度
[temperature_sensor T1-ambient]
sensor_type = ATC Semitec 104GT-2
sensor_pin = head1:TH_NTC
min_temp: -50
max_temp: 350

[heater_fan hotend_fan1]
pin: head1:FAN_HE
max_power: 1.0
kick_start_time: 0.5
heater: extruder1
heater_temp: 70.0 ; account for the high reading of SB2040 default 50.0
#fan_speed: 1.0

[fan_generic fanX2]
pin: head1:FAN_PC
cycle_time: 0.0100
kick_start_time: 1.00
hardware_pwm: false


#####################################################################
# 	Bed Heater
#####################################################################

[heater_bed]
##	SSR Pin - BED_OUT : PA1; HE1: PA3
heater_pin: PA3 # PA1
#sensor_type: NTC 100K beta 3950
sensor_type: NTC 100K MGB18-104F39050L32
sensor_pin: PF3
##	Adjust Max Power so your heater doesn't warp your bed
max_power: 0.6
min_temp: 0
#min_temp: -273.15
max_temp: 120
control: pid
pid_Kp:37.762 
pid_Ki:2.208 
pid_Kd:161.433

[verify_heater heater_bed]
#   This controls heater verification during initial heating. Smaller
#   values result in stricter checking and larger values allow for
#   more time before an error is reported. Specifically, during
#   initial heating, as long as the heater increases in temperature
#   within this time frame (specified in seconds) then the internal
#   "error counter" is reset. The default is 20 seconds for extruders
#   and 60 seconds for heater_bed.
check_gain_time: 90

#####################################################################
# 	Probe
#####################################################################


[named_probe tap1]
pin: head1:gpio28
idex_carriage: 1               ; 0 or 1
x_offset: 0
y_offset: 0
z_offset: -1.150
speed: 10.0
samples: 3
samples_result: median
sample_retract_dist: 3.0
samples_tolerance: 0.006
samples_tolerance_retries: 3

activate_gcode:
    {% set PROBE_TEMP = 150 %}
    {% set MAX_TEMP = PROBE_TEMP + 5 %}
    {% set ACTUAL_TEMP = printer.extruder.temperature %}
    {% set TARGET_TEMP = printer.extruder.target %}

    {% if TARGET_TEMP > PROBE_TEMP %}
        { action_respond_info('Extruder temperature target of %.1fC is too high, lowering to %.1fC' % (TARGET_TEMP, PROBE_TEMP)) }
        M109 S{ PROBE_TEMP }
    {% else %}
        # Temperature target is already low enough, but nozzle may still be too hot.
        {% if ACTUAL_TEMP > MAX_TEMP %}
            { action_respond_info('Extruder temperature %.1fC is still too high, waiting until below %.1fC' % (ACTUAL_TEMP, MAX_TEMP)) }
            TEMPERATURE_WAIT SENSOR=extruder MAXIMUM={ MAX_TEMP }
        {% endif %}
    {% endif %}

[named_probe tap0]
##	Inductive Probe
##	This probe is not used for Z height, only Quad Gantry Leveling

# Select the probe port by type:
## For the PROBE port; use this with the original OMRON sensor.
#pin: ~!PB7
pin: head0:gpio28
## For the spare endstop port; use this with the Fotek PL-05N (or generic) inductive probe
# pin: ^PG11
## For Octopus Pro Probe port; NPN and PNP proximity switch types can be set by jumper
# pin: ^PC5

#--------------------------------------------------------------------

idex_carriage: 0               ; 0 or 1
# Voron Tap
# Increasing z_offset brings nozzle closer to the bed
x_offset: 0
y_offset: 0
z_offset: -1.150   ;   -1.200  ; -1.250
speed: 10.0
samples: 3
samples_result: median
sample_retract_dist: 2.0
samples_tolerance: 0.006
samples_tolerance_retries: 3

activate_gcode:
    {% set PROBE_TEMP = 150 %}
    {% set MAX_TEMP = PROBE_TEMP + 5 %}
    {% set ACTUAL_TEMP = printer.extruder.temperature %}
    {% set TARGET_TEMP = printer.extruder.target %}

    {% if TARGET_TEMP > PROBE_TEMP %}
        { action_respond_info('Extruder temperature target of %.1fC is too high, lowering to %.1fC' % (TARGET_TEMP, PROBE_TEMP)) }
        M109 S{ PROBE_TEMP }
    {% else %}
        # Temperature target is already low enough, but nozzle may still be too hot.
        {% if ACTUAL_TEMP > MAX_TEMP %}
            { action_respond_info('Extruder temperature %.1fC is still too high, waiting until below %.1fC' % (ACTUAL_TEMP, MAX_TEMP)) }
            TEMPERATURE_WAIT SENSOR=extruder MAXIMUM={ MAX_TEMP }
        {% endif %}
    {% endif %}
    
[idex_offsets_calibration]
# offset_x parameters (mm)
# probing the calibration object on the back edge
offset_x_probe_site_t0_x:    132
#offset_x_probe_site_t1_x:    130           ; default to offset_x_probe_site_t0_x
offset_x_probe_site_y:       252.5
#offset_x_probe_site_z:       0             ; default 0
offset_x_step_size_t0:         0.50        ; how much to move each step initially, when doing offset_x calibration
#offset_x_step_size_t1:         0.50        ; default to offset_x_t0_step_size
# offset_x = T1_x - probe_differential_x - T0_x, default 0
# T1 color too far +X (right) => increase probe_differential_x
# T1 color too far -X (left)  => decrease probe_differential_x
probe_differential_x:          0.1

# probing left and right edges of the PEI sheet
#offset_x_probe_site_t0_x:     0
#offset_x_probe_site_t1_x:   245
#offset_x_probe_site_y:      125
#offset_x_probe_site_z:        0           ; default 0
#offset_x_step_size_t0:       -0.50        ; how much to move each step initially, when doing offset_x calibration
#offset_x_step_size_t1:        0.50        ; default to offset_x_t0_step_size
# offset_x = T1_x - probe_differential_x - T0_x, default 0
#probe_differential_x:       251.05        


# offset_y parameters (mm)
# probing the calibration object on the back edge
offset_y_probe_site_t0_x:     130
#offset_y_probe_site_t1_x:     75            ; default to offset_y_probe_site_t0_x
offset_y_probe_site_y:        252.5
#offset_y_probe_site_z: 0                    ; default 0
offset_y_step_size_t0:         -0.50        ;how much to move each step initially, when doing offset_y calibration
#offset_y_step_size_t1:         -0.50        ; default to offset_y_t0_step_size

# offset_y = T1_y - probe_differential_y - T0_y, default 0
# T1 color too far +Y (back)  => increase probe_differential_y
# T1 color too far -Y (front) => decrease probe_differential_y
probe_differential_y:          0.088             

# probing back edge of the PEI sheet
#offset_y_probe_site_t0_x:      200
#offset_y_probe_site_t1_x:       75               ; default to offset_y_probe_site_t0_x
#offset_y_probe_site_y:         249
#offset_y_probe_site_z:         0                   ; default 0
#offset_y_step_size_t0:         0.50         ;how much to move each step initially, when doing offset_y calibration
#offset_y_step_size_t1:         0.50        ; default to offset_y_t0_step_size
# offset_y = T1_y - probe_differential_y - T0_y, default 0
#probe_differential_y:          0.15               ; 

# offset_z parameters (mm)
offset_z_probe_site_x:        125
offset_z_probe_site_y:        125
#offset_z_probe_site_z:         0                   ; default 0
# offset_z = T1_z - probe_differential_z - T0_z, default 0
# T0 perfect, T1 too far from bed => increase probe_differential_z
# T0 perfect, T1 too close to bed => decrease probe_differential_z
probe_differential_z:           0.635

# general parameters (mm)
edge_threshold:                 0.25         ; if the differences between successive probing is larger, then we found the edge
edge_probing_distance:         10            ; how far to probe for
clearance:                     10            ; in z, default 20
sample_retract_dist:            2
samples:                        1


#####################################################################
# 	Fan Control
#####################################################################

#[fan]
##	Print Cooling Fan - CNC_FAN0
#pin: PA8
#kick_start_time: 0.5
##	Depending on your fan, you may need to increase this value
##	if your fan will not start. Can change cycle_time (increase)
##	if your fan is not able to slow down effectively
#off_below: 0.10

#[heater_fan hotend_fan]
##	Hotend Fan - CNC_FAN1
#pin: PE5
#max_power: 1.0
#kick_start_time: 0.5
#heater: extruder
#heater_temp: 50.0
##	If you are experiencing back flow, you can reduce fan_speed
#fan_speed: 1.0

[heater_fan controller_fan_out]
##	Controller fan
pin: FAN0
kick_start_time: 0.5
heater: heater_bed
heater_temp: 45.0
#heater_temp: 10.0   ; testing

[heater_fan controller_fan_in]
##	Controller fan
pin: FAN1
kick_start_time: 0.5
heater: heater_bed
heater_temp: 45.0
#heater_temp: 10.0   ; testing


[heater_fan exhaust_fan]
#[fan_generic exhaust_fan]
##	Exhaust fan
pin: FAN2
max_power: 1.0
shutdown_speed: 0.0
kick_start_time: 5.0
heater: heater_bed
heater_temp: 60
#heater_temp: 10  ; test
#fan_speed: 1.0

#####################################################################
# 	LED Control
#####################################################################

[output_pin caselight]
# Chamber Lighting - HE2 Connector (Optional)
pin: HE2
pwm: true
shutdown_value: 0
value:1
#cycle_time: 0.01

#--------------------------------------------------------------------
# SET_LED LED=stealthburner RED=1 GREEN=1 BLUE=1 INDEX=1 TRANSMIT=0
# 
[neopixel sb_leds_T0]
pin: head0:gpio12
chain_count: 3
color_order: GRBW
initial_RED: 0.0
initial_GREEN: 0.0
initial_BLUE: 0.0
initial_WHITE: 1.0

[neopixel sb_leds_T1]
pin: head1:gpio12
chain_count: 3
color_order: GRBW
initial_RED: 0.0
initial_GREEN: 0.0
initial_BLUE: 0.0
initial_WHITE: 1.0

#####################################################################
# 	Homing and Gantry Adjustment Routines
#####################################################################

[idle_timeout]
timeout: 3600 #1800

#[safe_z_home]
##	XY Location of the Z Endstop Switch
##	Update -10,-10 to the XY coordinates of your endstop pin 
##	(such as 157,305) after going through Z Endstop Pin
##	Location Definition step.
#home_xy_position:143, 250
#speed:100
#z_hop:10

[z_tilt]
##	Use Z_TILT_ADJUST to level the bed .
##	z_positions: Location of toolhead

##--------------------------------------------------------------------
## Uncomment below for 250mm build
z_positions:
	-88, 17   #stepper_z - left front (should be negative)
  125, 325  #stepper_z1 - rear
	338, 0    #stepper_z2 - right front
points:
    30, 30   #10, 19	  # X 30, Y 5 stepper_z Probe position (nozzle coordinates) 
    125, 220 #125, 215  
    220, 30 #238, 19	
    
speed: 200
horizontal_move_z: 10
retries: 5
retry_tolerance: 0.0075

# https://github.com/KevinOConnor/klipper/blob/master/docs/Bed_Mesh.md
# BED_MESH_CALIBRATE
# BED_MESH_PROFILE SAVE=name LOAD=name REMOVE=name
[bed_mesh]
speed: 300
#horizontal_move_z: 2
# 2mm triggers the probe
horizontal_move_z: 15
##--------------------------------------------------------------------
##	Uncomment below for 250mm build
mesh_min: 40, 40
mesh_max: 210,210

##	Uncomment for 300mm build
#mesh_min: 40, 40
#mesh_max: 260,260

##	Uncomment for 350mm build
#mesh_min: 40, 40
#mesh_max: 310,310
##--------------------------------------------------------------------
fade_start: 0.6
fade_end: 10.0
probe_count: 5,5
algorithm: bicubic
# relative_reference_index = ((x points * y points) - 1)/2
relative_reference_index: 12


#   The servos may be controlled using the SET_SERVO g-code command. 
#   For example: SET_SERVO SERVO=my_servo ANGLE=180

[servo arm]
pin: PG11           # PG11 # PB6 is for Octopus Pro, use the appropriate pin for your MCU
#   PWM output pin controlling the servo. This parameter must be
#   provided.
maximum_servo_angle: 180    # 180 vertical model
#   The maximum angle (in degrees) that this servo can be set to. The
#   default is 180 degrees.
minimum_pulse_width: 0.0005
#   The minimum pulse width time (in seconds). This should correspond
#   with an angle of 0 degrees. The default is 0.001 seconds.
maximum_pulse_width: 0.0025
#   The maximum pulse width time (in seconds). This should correspond
#   with an angle of maximum_servo_angle. The default is 0.002
#   seconds.
initial_angle: 155    # default to 0 which corresponds to retracted
#   Initial angle (in degrees) to set the servo to. The default is to
#   not send any signal at startup.
#initial_pulse_width:
#   Initial pulse width time (in seconds) to set the servo to. (This
#   is only valid if initial_angle is not set.) The default is to not
#   send any signal at startup.

#--------------------------------------------------------------------

[input_shaper]
shaper_freq_x: 67.2           # AfterBurner
#   A frequency (in Hz) of the input shaper for X axis. This is
#   usually a resonance frequency of X axis that the input shaper
#   should suppress. For more complex shapers, like 2- and 3-hump EI
#   input shapers, this parameter can be set from different
#   considerations. The default value is 0, which disables input
#   shaping for X axis.
#shaper_freq_y: 55.8           # AfterBurner
#   A frequency (in Hz) of the input shaper for Y axis. This is
#   usually a resonance frequency of Y axis that the input shaper
#   should suppress. For more complex shapers, like 2- and 3-hump EI
#   input shapers, this parameter can be set from different
#   considerations. The default value is 0, which disables input
#   shaping for Y axis.
#shaper_type: 
#   A type of the input shaper to use for both X and Y axes. Supported
#   shapers are zv, mzv, zvd, ei, 2hump_ei, and 3hump_ei. The default
#   is mzv input shaper.
shaper_type_x: mzv            # AfterBurner
shaper_type_y: mzv            # AfterBurner
#shaper_type_x: mzv            # Orbiter 1.5 / Galileo
#shaper_type_y: mzv            # Orbiter 1.5 / Galileo
#   If shaper_type is not set, these two parameters can be used to
#   configure different input shapers for X and Y axes. The same
#   values are supported as for shaper_type parameter.
damping_ratio_x: 0.1
damping_ratio_y: 0.1
#   Damping ratios of vibrations of X and Y axes used by input shapers
#   to improve vibration suppression. Default value is 0.1 which is a
#   good all-round value for most printers. In most circumstances this
#   parameter requires no tuning and should not be changed.


# Below are for Moonraker
[virtual_sdcard]
path: ~/.octoprint/uploads/
#   The path of the local directory on the host machine to look for
#   g-code files. This is a read-only directory (sdcard file writes
#   are not supported). One may point this to OctoPrint's upload
#   directory (generally ~/.octoprint/uploads/ ). This parameter must
#   be provided.
#on_error_gcode:
#   A list of G-Code commands to execute when an error is reported.

[pause_resume]
#recover_velocity: 50.
#   When capture/restore is enabled, the speed at which to return to
#   the captured position (in mm/s). Default is 50.0 mm/s.

[display_status]

[respond]

#####################################################################
# 	Macros
#####################################################################

#[include klicky-probe.cfg]
#[include retractable_probe_dock.cfg]
#[include z_calibration.cfg]
    
[gcode_macro IDEX_HOME_Y]
gcode:
    #BED_MESH_CLEAR
    SET_KINEMATIC_POSITION Z=0
    # Home
    G28 Y0
    # Move away
    G1 Y220 F2400

[gcode_macro IDEX_HOME_X]
gcode:
    BED_MESH_CLEAR
    G1 Y125 F2400
    G28 X0
    ACTIVATE_EXTRUDER EXTRUDER=extruder1
    SET_DUAL_CARRIAGE CARRIAGE=1
    G1 X150 F6000
    T0

[gcode_macro HOME_Z]
gcode:
    G1 X125 Y125 F6000
    G28 Z0
    G1 Z15 F2400
    
[gcode_macro homed]
gcode:
    { action_respond_info(printer.toolhead.homed_axes) }
                
[gcode_macro G32]
gcode:
    BED_MESH_CLEAR
    IDEX_HOME_Y
    IDEX_HOME_X
    HOME_Z
    #G28
    #CLEAN_NOZZLE
    #G28 Z                 ; reset z so attach_probe can work
    Z_TILT_ADJUST
    #G28
    ##	Uncomment for for your size printer:
    #--------------------------------------------------------------------
    ##	Uncomment for 250mm build
    #G0 X125 Y125 Z30 F3600
    
    ##	Uncomment for 300 build
    #G0 X150 Y150 Z30 F3600
    
    ##	Uncomment for 350mm build
    #G0 X175 Y175 Z30 F3600
    #--------------------------------------------------------------------

[gcode_macro HOME]
gcode:
    IDEX_HOME_Y
    IDEX_HOME_X
    HOME_Z

[gcode_macro HOME_XY]
gcode:
    IDEX_HOME_Y
    IDEX_HOME_X
       
[gcode_macro PRINT_START]
#   Use PRINT_START for the slicer starting script - please customise for your slicer of choice
gcode:
    # Below is for Voron Tap
    M117 Preheating nozzle
    M104 S150                          ; Start nozzle heating to 150C - soften filament, but no ooze
    
    {% if 'BED' in params %}
        M117 Heating bed               ; Add the heating codes for Superslicer
        M190 S{ params.BED }
    {% endif %}
    
    M109 S150                          ; Wait for nozzle to heat to 150C
    
#    SET_FILAMENT_SENSOR SENSOR=btt_sensor ENABLE=0
    {% if not ('xyz' in printer.toolhead.homed_axes) %}
        G32                            ; home all axes, Z Tilt Adjust, etc.
    {% endif %}
    
;     {% if ('HOTEND0' in params and params.HOTEND0 > 0) 
;           and ('HOTEND1' in params and params.HOTEND1 > 0) 
;           and (printer.idex_offsets_calibration.last_offset_x == None 
;                or printer.idex_offsets_calibration.last_offset_y == None 
;                or printer.idex_offsets_calibration.last_offset_z == None) %}
;         CALIBRATE_IDEX_OFFSETS
;         UPDATE_IDEX_OFFSETS
;     {% endif %}
    
    {% if 'HOTEND0' in params and params.HOTEND0 > 0 %}
        M117 Heating T0 nozzle 
        M104 T0 S{ params.HOTEND0 }
    {% endif %}
    {% if 'HOTEND1' in params and params.HOTEND1 > 0 %}
        M117 Heating T1 nozzle 
        M104 T1 S{ params.HOTEND1 }
    {% endif %}
    
    
    {% if 'BED' in params %}
        M117 Heating bed               ; Add the heating codes for Superslicer
        M190 S{ params.BED }
    {% endif %}
    {% if 'HOTEND0' in params and params.HOTEND0 > 0 %}
        M117 Waiting to heat T0 nozzle 
        M109 T0 S{ params.HOTEND0 }
    {% endif %}
    {% if 'HOTEND1' in params and params.HOTEND1 > 0 %}
        M117 Waiting to heat T1 nozzle 
        M109 T1 S{ params.HOTEND1 }
    {% endif %}
    
    #M117 Clean nozzle...
    #clean_nozzle
    #G28 Z                          ; home z axis again after cleaning nozzle
    #CALIBRATE_Z                    ; this replaces the second Z homing
    #BED_MESH_PROFILE LOAD=default  ; load default bed mesh
    G1 Z30 F3000                   ; move nozzle away from bed
    M117 Printing...


[gcode_macro PRINT_END]
#   Use PRINT_END for the slicer ending script - please customise for your slicer of choice
gcode:
    M400                           ; wait for buffer to clear
    G92 E0                         ; zero the extruder
    G1 E-10.0 F3600                ; retract filament
    G91                            ; relative positioning
    G0 Z1.00 X20.0 Y20.0 F20000    ; move nozzle to remove stringing
    TURN_OFF_HEATERS
    M107                           ; turn off fan
    G1 Z2 F3000                    ; move nozzle up 2mm
    G90                            ; absolute positioning
    T0
    G0 X125 Y240 F3600       ; park nozzle at rear
    {% if printer.toolhead.position.z < 150 %}
        G0 Z150
    {% endif %}
    BED_MESH_CLEAR

[gcode_macro LOAD_FILAMENT]
gcode:
    {% set speed = params.SPEED|default(300) %}
    {% if printer.dual_carriage.active_carriage == "CARRIAGE_0" %}
        {% set max_velocity = printer.configfile.settings['extruder'].max_extrude_only_velocity %}
    {% else %}
        {% set max_velocity = printer.configfile.settings['extruder1'].max_extrude_only_velocity %}
    {% endif %}
    SAVE_GCODE_STATE NAME=load_state
    M300 # beep
    G91
    G92 E0
    G1 E350 F{max_velocity} # fast-load
    G1 E25 F{speed} # purge
    M300
    M300
    RESTORE_GCODE_STATE NAME=load_state
    
[gcode_macro UNLOAD_FILAMENT]
gcode:
    {% set speed = params.SPEED|default(300) %}
    {% if printer.dual_carriage.active_carriage == "CARRIAGE_0" %}
        {% set max_velocity = printer.configfile.settings['extruder'].max_extrude_only_velocity %}
    {% else %}
        {% set max_velocity = printer.configfile.settings['extruder1'].max_extrude_only_velocity %}
    {% endif %}
    SAVE_GCODE_STATE NAME=unload_state
    G91
    M300 # beep
    G92 E0
    G1 E25 F{speed} # purge
    G1 E-420 F{max_velocity} # fast-unload
    M300
    M300
    RESTORE_GCODE_STATE NAME=unload_state    
## 	Thermistor Types
##   "EPCOS 100K B57560G104F"
##   "ATC Semitec 104GT-2"
##   "NTC 100K beta 3950"
##   "Honeywell 100K 135-104LAG-J01"
##   "NTC 100K MGB18-104F39050L32" (Keenovo Heater Pad)
##   "AD595"
##   "PT100 INA826"

#*# <---------------------- SAVE_CONFIG ---------------------->
#*# DO NOT EDIT THIS BLOCK OR BELOW. The contents are auto-generated.
#*#
#*# [bed_mesh default]
#*# version = 1
#*# points =
#*# 	  0.035000, 0.040000, 0.050000, 0.010000, 0.012500
#*# 	  0.007500, 0.050000, 0.022500, -0.025000, -0.005000
#*# 	  0.010000, 0.025000, 0.000000, -0.030000, -0.005000
#*# 	  0.010000, 0.065000, 0.042500, 0.020000, 0.017500
#*# 	  -0.032500, 0.022500, 0.012500, 0.010000, 0.040000
#*# tension = 0.2
#*# min_x = 40.0
#*# algo = bicubic
#*# y_count = 5
#*# mesh_y_pps = 2
#*# min_y = 40.0
#*# x_count = 5
#*# max_y = 210.0
#*# mesh_x_pps = 2
#*# max_x = 210.0
