tronfu/Voron-Mods/(commit log)

2022-01-23 Initial commit
    Initial commit
    [Housing.stl, Impact_relief.stl, Servo_arm.stl]
2022-01-23 Added sample klicky-probe.cfg
    [klicky-probe.cfg]
2022-01-23 Added servo_dock_and_brush.jpg
2022-01-28 Adding Better Bed Hinge
    Adding Better Bed Hinge
    [Bed_handle.stl, Deck_Panel_350_Modified.dxf, Voron_2.4_Deck_Panel_Hole_Plug_x4.stl]
2022-02-01 Added DIN frame mount
    [DIN_frame_mount_x4.stl]
2022-02-18 Added Bowden tube clip
    [Bowden_tube_clip.stl]
2022-03-03 Added support for Trident and auto setting docklocation_z
    [Adjustable_arm.stl, Adjustable_brush_dock_holder.stl, Trident_housing.stl, retractable_probe_dock.cfg]
2022-03-03 Cleaned up calibrate_docklocation_z config
    [retractable_probe_dock.cfg]
2022-03-06 Revised the design for better printing and less stress on the Bowden tube
    [Bowden_tube_clip.stl]
2023-02-01 Initial commit
    Initial commit of servo-powered nozzle brush.
    [servo_arm.cfg, servo_nozzle_brush.cfg]
2023-02-01 Added SKR and servo images
    Added SKR and servo images
2023-02-01 Added brush only holder
    [Adjustable_brush_holder.stl]
2023-03-07 Initial commit
    This is a collection of Klipper modules and macros that will automatically find the x, y, and z offsets between tool head 1 (T1) and tool head 0 (T0) in an IDEX setup.
    [IDEX_mode.cfg, pins.cfg, printer.cfg]
2023-03-07 Updated example printer.cfg
    [printer.cfg]
